rivques/AutoMusicBoxHolePuncher/README.md

# AutoMusicBoxHolePuncher
Code and CAD for a robot that automatically punches holes in music box paper.
Docs live [on River's website](https://https://rivques.dev/high-school-engineering/auto-music-box-hole-puncher/) and [on this repo](/docs/index.md).
