rivques/AutoMusicBoxHolePuncher/(list of files, drawings)

Other design files:
designs/circuit.fzz
