rivques/AutoMusicBoxHolePuncher/(commit log)

2023-01-06 TUI is buggy but has code
    [code.py]
2023-01-10 fix a really annoying asyncio/gc/memory error
    [code.py]
2023-01-12 add fritzing sketch and consolidate some vars
    [circuit.fzz]
2023-01-17 debug: going backwards breaks things (still broken)
    [circuit.fzz]
2023-01-19 it works! (got rid of microstepping, 0.2mm whole step res is fine)
2023-02-07 fine-tune servo angles
2023-02-13 tune y axis
2023-03-07 adapt code for solenoid
2023-03-10 actually wait we are using a drill
2023-05-18 add link to Onshape in CAD section
